euzebio-ers/Robo-Sumo-SENAI-2025/media/1.jpg

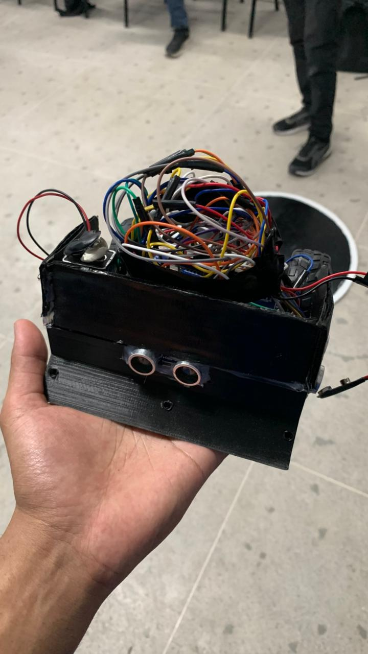
media/1.jpg
