euzebio-ers/Robo-Sumo-SENAI-2025/docs/Esquemático.pdf

A

1 | 2 | 3 | 4 | 5 | 6

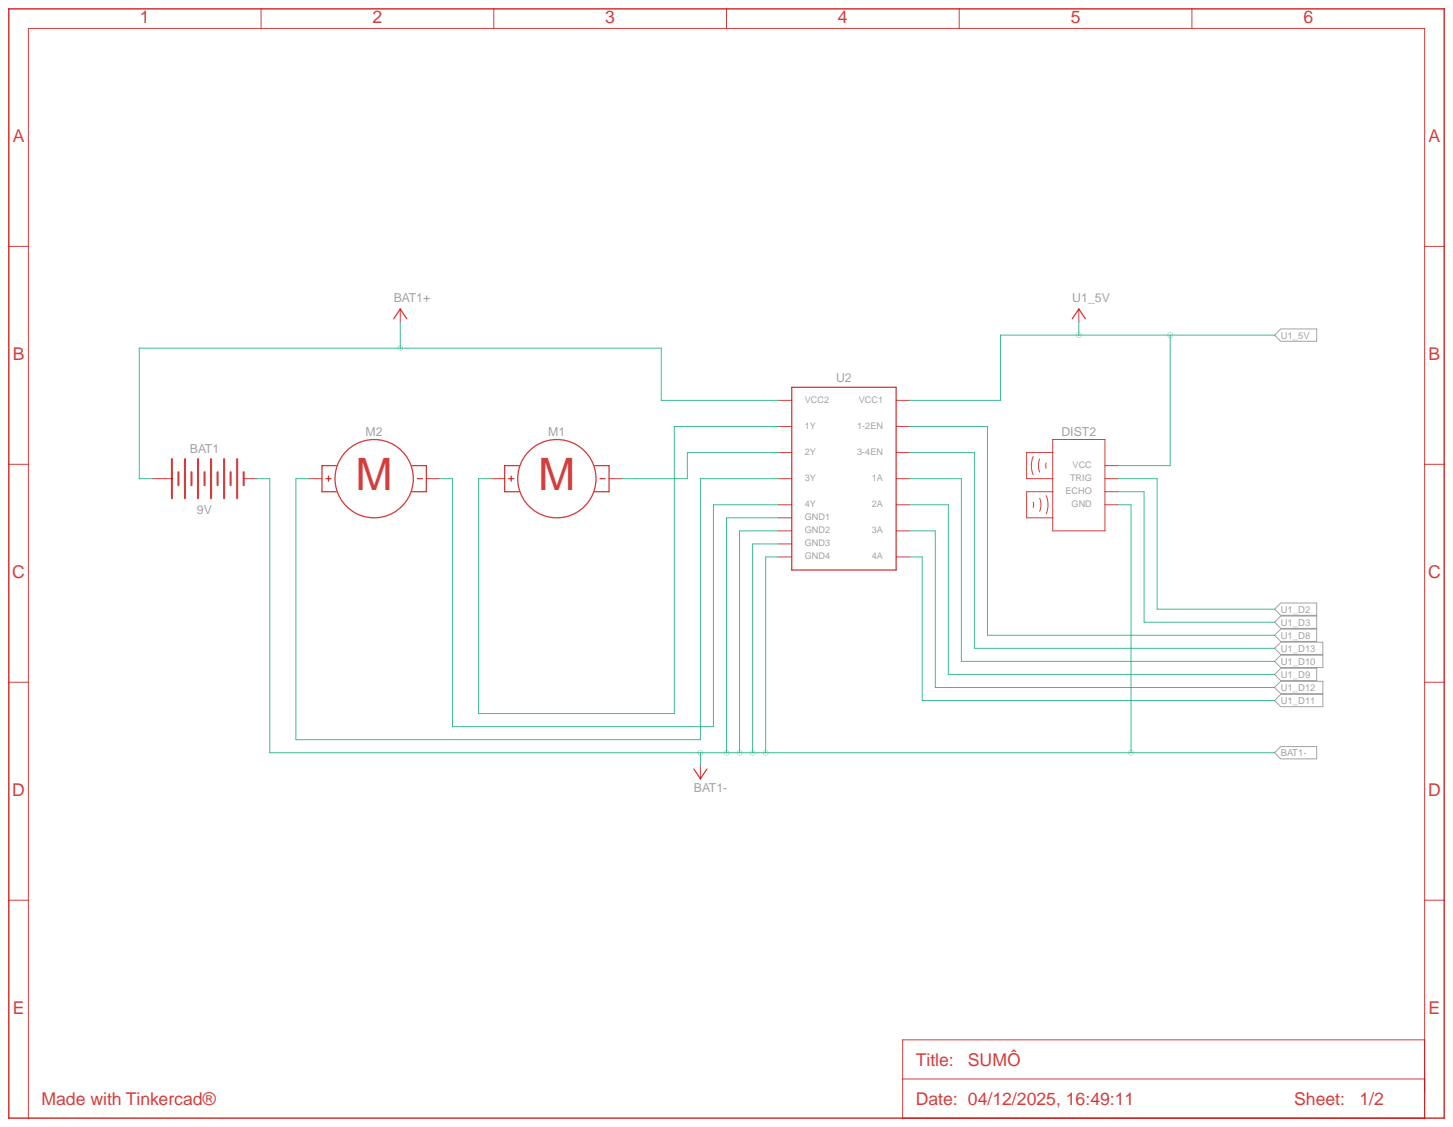
[picture p2: page 1]
Title: SUMÔ; Date: 04/12/2025, 16:49:11; Sheet: 1/2; BAT1; GND1 GND2; VCC2; VCC1; GND3 GND4; VCC TRIG; GND; ECHO; DIST2; BAT1+; BAT1-

Made with Tinkercad®

A

1 | 2 | 3 | 4 | 5 | 6

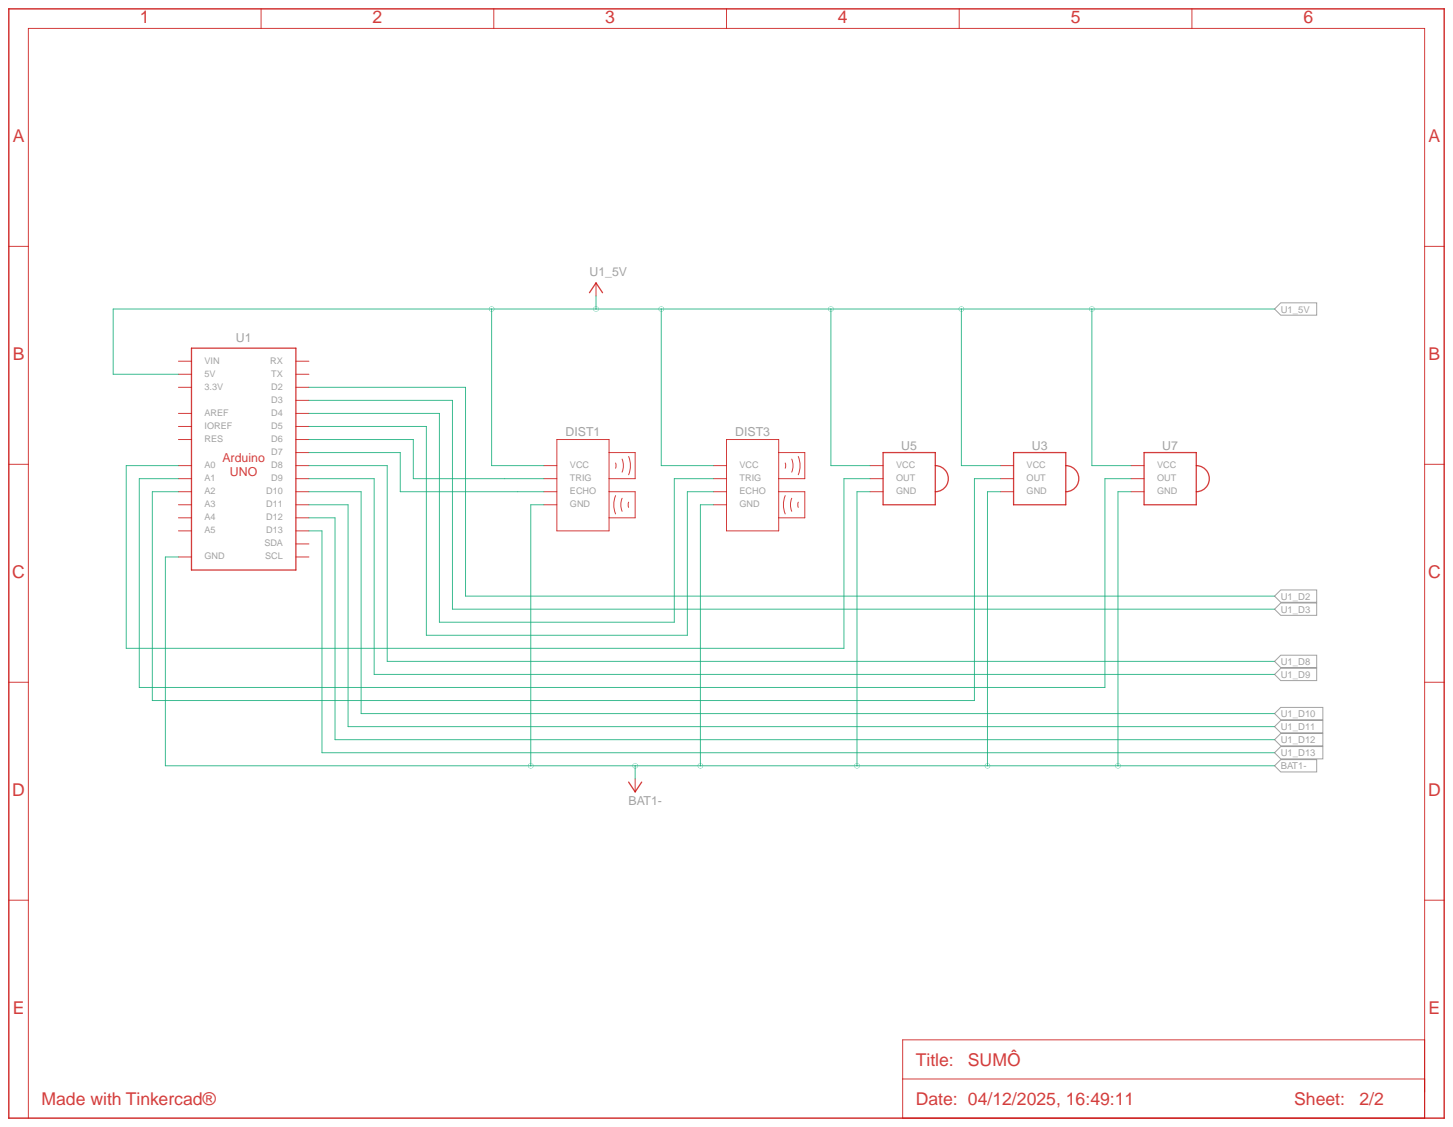
[picture p3: page 2]
